LieBtrau/nuc/Simulation/nuc.asc

C1: cap; 1
C3: cap; 1
C4: cap; 1
D1: LED; NSCW100
D2: LED; NSCW100
Q1: npn; 2N2222
Q2: npn; 2N2222
R1: res; 470
R2: res; 15K
R3: res; 12K
R4: res; 4.7
R5: res; 4.7
R6: res; 1.5
R7: res; 4.7
R8: res; 12K
R9: res; 470
U1: TLV431
U2: TLV431
V1: voltage; 5.5
Named nets: 0
.tran 0 100s 0.1 uic
V1: USB-voltage: 4.5-5.5V
Charging busy indicator: R8, R9, D2, Q2
C1, C4: AAA-cells (will be charged at 80mA)
C3, open space next to C4 (during simulation, C4 is moved to the empty space): AA-cells (will be charged at 200mA)
R4, R5, R6, R7: charging sensing current resistors (all four resistors in series: sensing 80mA, R5+R6: sensing 200mA)
Charge AAA or AA, not both types at the same time.
R2, R3, U1, D1: overvoltage detection sharply decreases charging current to a safe level for the battery. D1 will go on then.
Q1, R1, U2: charge current control.
