LieBtrau/nuc/Simulation/NiMH_Charger_TLV431.asc

C1: cap; 1
C2: cap; 1
C3: cap; 1
D1: LED; NSCW100
D2: LED; NSCW100
M1: pmos; RSQ035P03
Q1: pnp; BC857B
R1: res; 1
R2: res; 68K
R3: res; 150k
R4: res; 3.3K
R5: res; 150K
R6: res; 36K
R7: res; 15K
R8: res; 68K
R9: res; 220
R10: res; 150K
R11: res; 360K
R12: res; 3.3K
R13: res; 10meg
R14: res; 10meg
R15: res; 220
R16: res; 360K
R17: res; 68K
R18: res; 150K
U1: TLV431
U2: PSMN069-100YS
U3: TLV431
U4: TLV431
U5: PSMN069-100YS
U6: TLV431
U7: TLV431
V1: voltage; 4.5
Named nets: 0
;op
.tran 0 10 0.01 uic
Reference voltage set at 4.0V: needed, so that charging current is less dependent on supply voltage: R8, R9, R10, U3
Charge current control set at 200mA: R1, R2, R3, R4, R11, U1, U2
Overvoltage protection set at 4.2V: R6, R7, R12, U4, Q1
Charger disconnect protection: protects the charger, containing charged batteries, when not connected to the power supply: M1, U5
Batteries that must be charged (simple spice model): C1, C2, C3
Components to suppress Spice warnings: R13, R14
U2, U5, M1: can be any low RdsOn, low Vth. MOSFET
Charging ongoing LED indicator: R5, R15, R16, D1, U6.
Supply voltage V1: [4.5 5.5] V : meant for USB-port, connect D- to D+ of USB connector.
Charging finished LED indicator: R15, R18, D2, U7
D1, D2 can be part of an RGB-LED, e.g. Nichia NECM325-C
R7 = 27K + 1K8 for 2cells
