LieBtrau/nuc/(list of files, drawings)

Other design files:
Hardware/BRD131005.pcbdoc
Hardware/NUC.PrjPCB
Hardware/NUC.SchDoc
