LieBtrau/nuc/(commit log)

2013-10-08 Updating outputs
    [BRD131005.pcbdoc, NUC.PrjPCB]
2013-10-31 Adding voltage reference to current control, to increase PSRR.
2013-10-31 Replacing BJT by NMOS to increase the compliance range of the current source. Otherwise it's impossible to charge 3 NiMH cells with 5V +/- 10%
2013-10-31 -NMOS current sourcing transistor 200mA -overvoltage protection 4.2V -voltage reference 4.0V -adding model of PSMN069-100YS NMOS (this type seems overkill for this application, but it has a low RdsOn)
2013-11-01 Overvoltage protection, charger disconnected protection with NMOS/PMOS
2013-11-02 Adding charging LED indication.
2013-11-03 Updating values of resistors for charge current indication.
2013-11-27 Solving the reported issues: -independent of supply voltage -charge busy/finished LED indicator -protecting the circuit when power removed, but when charged batteries connected. -charging 3NiMH cells
2013-11-30 Adding R18: when charging was finished, USB was still supplying 100mA current when R18 was 0ohm.
2013-12-02 NUC R1
    [BRD131005.pcbdoc, NUC.PrjPCB, NUC.SchDoc]
2013-12-03 adding two annular rings for USB-connector position pins (only necessary for slide-print of the layout. Setting correct printer for printing PCB-layout.
    [BRD131005.pcbdoc]
2013-12-04 -Updating LED packages -Adding order code for 15K resistor -Adding BOM in CSV format
    [BRD131005.pcbdoc, NUC.SchDoc]
